smsaad-181/Clock-with-ATmega328P-and-RTC-/README.md

# Clock-with-ATmega328P-and-RTC-
Standalone digital clock using an Atmega328P microcontroller with RTC(DS1307) and 7-segment LED displays
