smsaad-181/Clock-with-ATmega328P-and-RTC-/2D_PCB1_2026-02-21.png

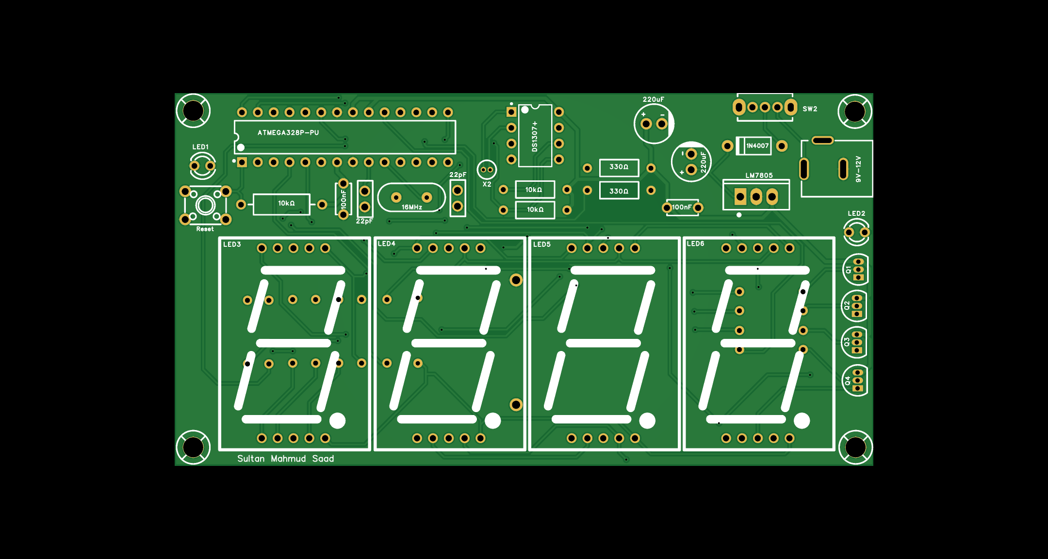
2D_PCB1_2026-02-21.png
