smsaad-181/Clock-with-ATmega328P-and-RTC-/3D_PCB1_2026-02-21.png

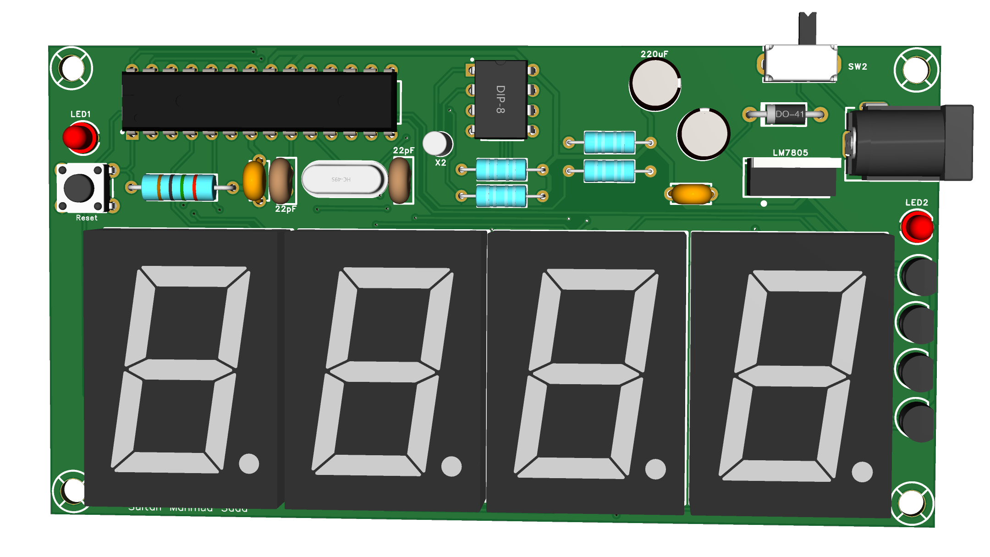
3D_PCB1_2026-02-21.png
