smsaad-181/Clock-with-ATmega328P-and-RTC-/BOM_Board1_PCB1_2026-02-21.xlsx

No. | Quantity | Comment | Designator | Footprint | Value | Manufacturer Part | Manufacturer | Supplier Part | Supplier
1 | 1 | DC-005 2.0 | 9V-12V | DC-IN-TH_DC-005-5.5-2.0 |  | DC-005 2.0 | BOOMELE(博穆精密) | C16214 | LCSC
2 | 1 | BS-2-1 | B1 | BAT-TH_BS-2-1 |  | BS-2-1 | QIJEY | C70376 | LCSC
3 | 2 | 22pF | C1,C2 | CAP-TH_L5.8-W2.4-P2.54-D0.6 | 22pF | CC1H220KA1EDCH4B1100 | Dersonic(德尔创) | C2832510 | LCSC
4 | 2 | 100nF | C3,C4 | CAP-TH_L5.0-W2.5-P5.00-D1.0 | 100nF | CC1H104MC1FD3F6C10MF | Dersonic(德尔创) | C254085 | LCSC
5 | 1 | LED_TH-G_3mm | LED1 | LED-TH_BD3.0-P2.54-FD
6 | 1 | LED_TH-R_3mm | LED2 | LED-TH_BD3.0-P2.54-FD
7 | 4 | FJ11001BH | LED3,LED4,LED5,LED6 | LED-SEG-TH_10P-L34.0-W24.0-P2.54-S30.48-BL |  | FJ11001BH | 志浩 | C12189 | LCSC
8 | 4 | 2N3904G-T92-B | Q1,Q2,Q3,Q4 | TO-92-3_L4.9-W3.7-P1.27-L |  | 2N3904G-T92-B | UTC(友顺) | C258453 | LCSC
9 | 1 | 10kΩ | R1 | RES-TH_BD3.3-L9.0-P13.00-D0.6 | 10kΩ
10 | 2 | 330Ω | R2,R3 | RES-TH_BD2.7-L6.2-P10.20-D0.4 | 330Ω | CR1/4W-330Ω±5%-OT52 | VO(翔胜) | C2894590 | LCSC
11 | 2 | 10kΩ | R4,R5 | RES-TH_BD2.7-L6.2-P10.20-D0.4 | 10kΩ | MF1/4W-10K±1%-ST52 | VO(翔胜) | C2903232 | LCSC
12 | 1 | 6.8kΩ | R6 | RES-TH_BD2.3-L6.5-P10.50-D0.5 | 6.8kΩ | MF1/2WS-6.8KΩ±1% T | CCO(千志电子) | C129911 | LCSC
13 | 4 | Screw-Hole-M3 | SCREW1,SCREW2,SCREW3,SCREW4 | Screw-Hole-M3
14 | 1 | TS-1102-4316 | SW1 | KEY-TH_4P-L6.0-W6.0-P4.50-LS6.5 |  | TS-1102-4316 | SOFNG(硕方) | C111374 | LCSC
15 | 1 | SK12D07VG3 | SW2 | SW-TH_SK12D07VG3 |  | SK12D07VG3 | SHOU HAN(首韩) | C431547 | LCSC
16 | 1 | ATMEGA328P-PU | U1 | DIP-28_L34.6-W7.3-P2.54-LS10.2-BL |  | ATMEGA328P-PU | MICROCHIP(美国微芯) | C33901 | LCSC
17 | 1 | 1N4007 | U3 | DO-41_BD2.4-L4.7-P8.70-D0.6-RD |  | 1N4007 | CJ(江苏长电/长晶) | C5261026 | LCSC
18 | 2 | 220uF | U4,U6 | CAP-TH_BD6.3-P2.50-D0.6-FD | 220uF | 25V220uF CD288 | HRK(鸿瑞凯电子) | C2960221 | LCSC
19 | 1 | LM7805T | U5 | TO-220-3_L10.1-W4.7-P2.54-L |  | LM7805T | HGSEMI(华冠) | C7432180 | LCSC
20 | 4 | 100kΩ | U8,U9,U10,U11 | RES-TH_BD2.7-L6.2-P10.20-D0.4 | 100kΩ | MF1/4W-100K±1%-OT26 | VO(翔胜) | C2843019 | LCSC
21 | 1 | DS1307+ | U12 | DIP-8_L9.8-W6.6-P2.54-LS7.6-BL |  | DS1307+ | ADI(亚德诺)/MAXIM(美信) | C59267 | LCSC
22 | 7 | 150Ω | U13,U14,U15,U16,U17,U18,U19 | RES-TH_BD2.7-L6.2-P10.20-D0.4 | 150Ω | KNP1WS-150Ω±5%-XT52 | VO(翔胜) | C479230 | LCSC
23 | 1 | 16MHz | X1 | OSC-TH_L10.0-W4.5-P5.00 | 16MHz | X49SD16MSD2SC | YXC(扬兴晶振) | C16212 | LCSC
24 | 1 | - | X2 | OSC-TH_BD3.0-P1.10-D0.4 | - | DT-38 32.768KHz | KDS(大真空) | C93228 | LCSC
