smsaad-181/Clock-with-ATmega328P-and-RTC-/Schamatic/SCH_Schematic1_2026-02-21.pdf

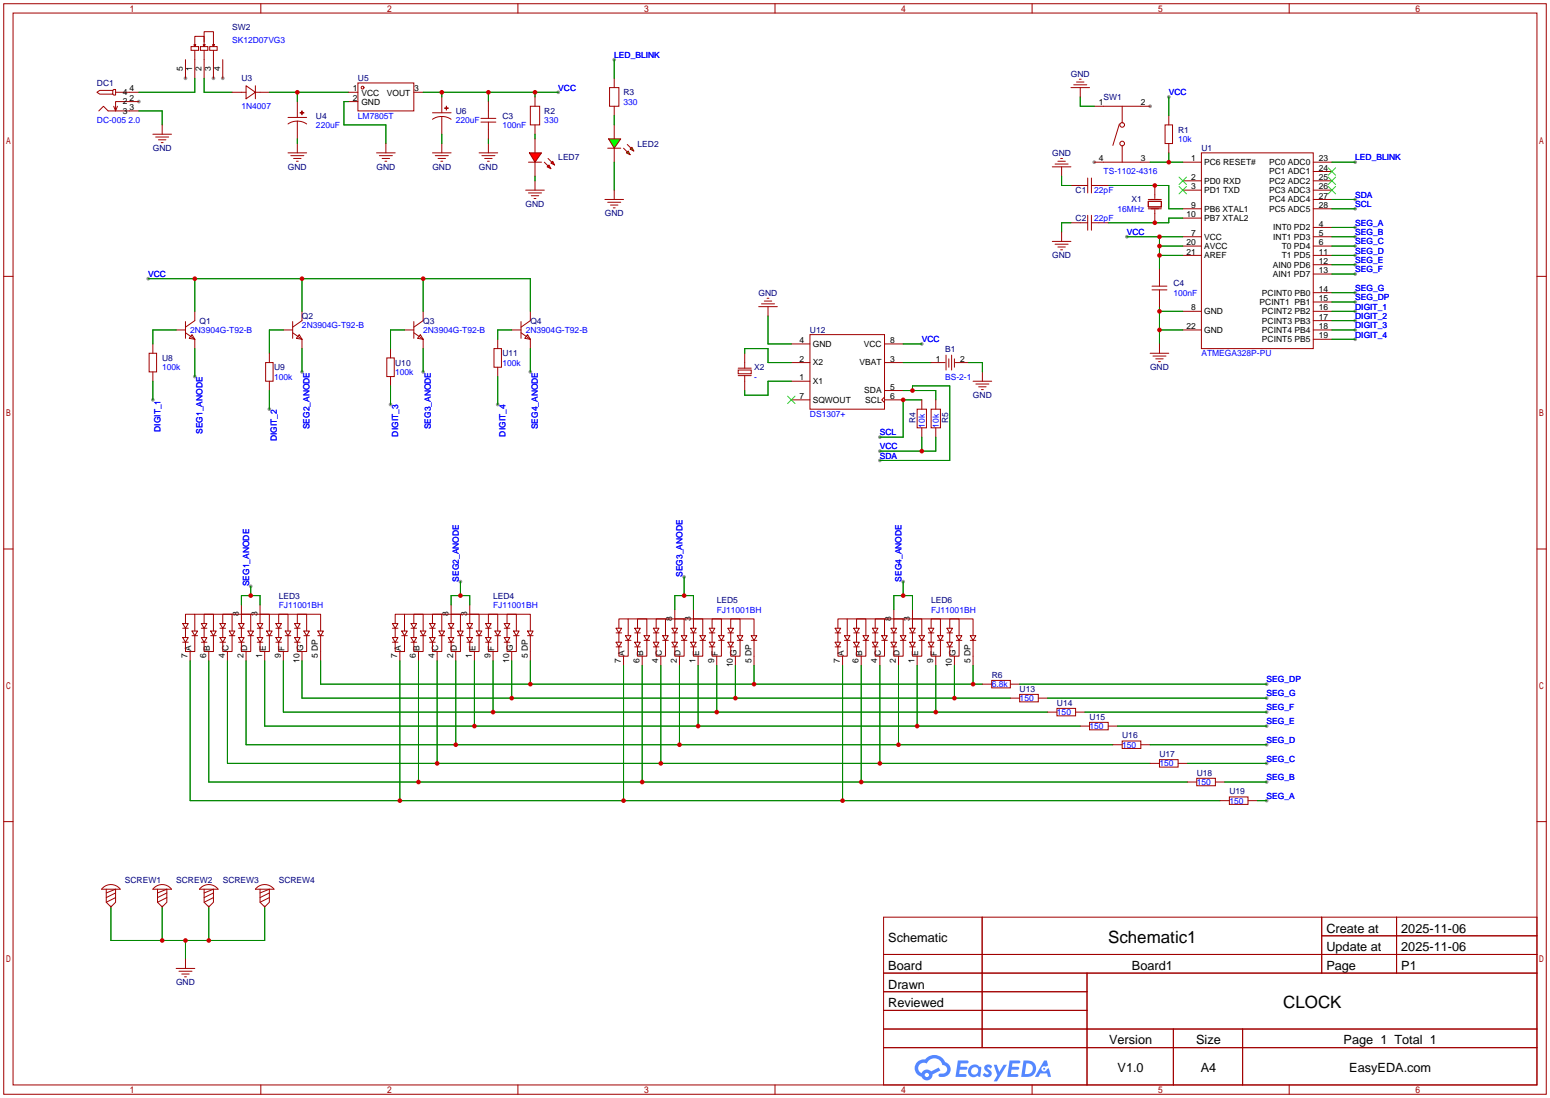
[picture p3: page 1]

Schematic | Schematic1 | Create at | 2025-11-06

Update at | 2025-11-06

Board | Board1 | Page | P1
Drawn | | CLOCK
Reviewed

Version | Size | Page 1 Total 1
V1.0 | A4 | EasyEDA.com
