smsaad-181/Clock-with-ATmega328P-and-RTC-/PCB_PCB1_2026-02-21.pdf

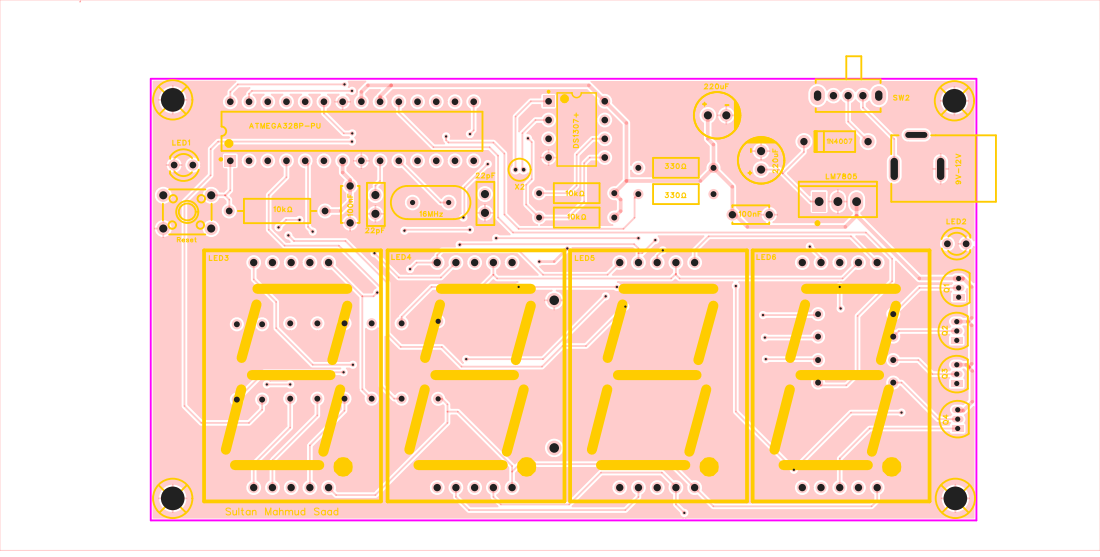
[picture p4: page 1]

LED2 Q¹ Q² Q³ Q⁴

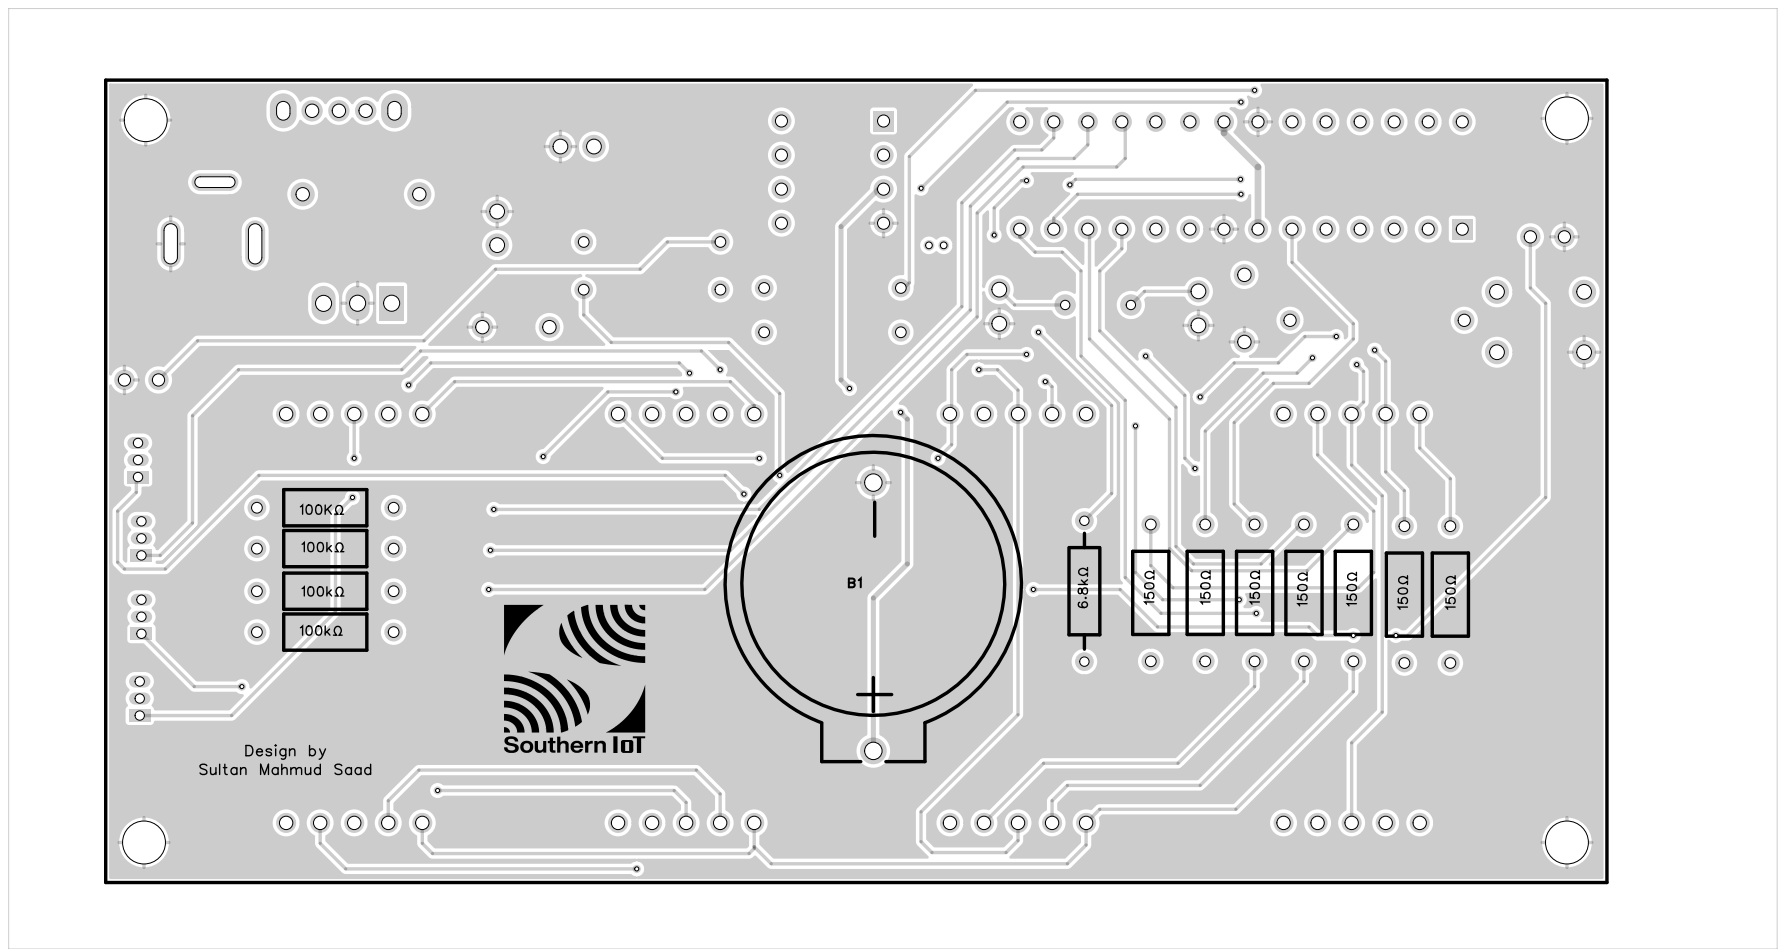
[picture p5: page 2]

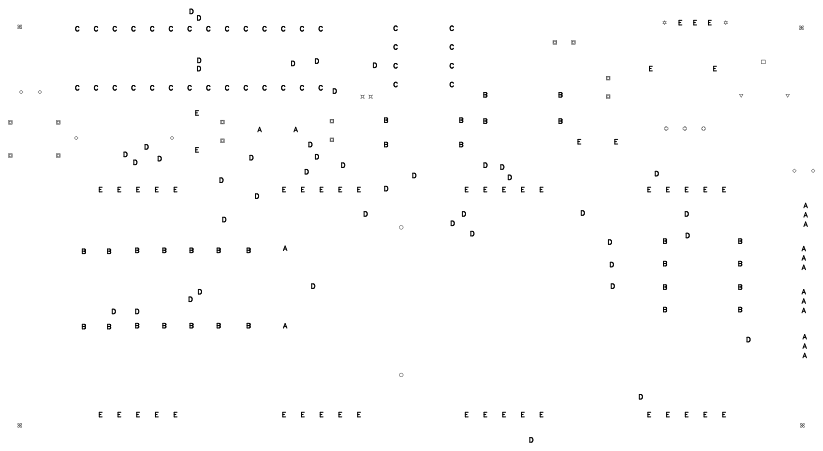
[picture p6: page 3]
