smsaad-181/Clock-with-ATmega328P-and-RTC-/(list of files, drawings)

Other design files:
Schamatic/ProPrj_CLOCK_2026-02-21.epro
